Gcampb7/ECE445/arch.scad

difference(){
cylinder(0.5,3.1, 3.1, $fn = 100);
translate([-3.15,0, -0.1]){cube(6.3, 6.3, .7);}
}
