Gcampb7/ECE445/Base_Addition.scad

difference(){
    cube([15, 15, 0.5], center = true);
    cube([14.5, 14.5, 1], center =true);
}
