Gcampb7/ECE445/slip_ring_sup.scad

difference() {
    color("green"){cylinder(16.7, 13.5, 13.5, $fn= 100 );}
    translate([0,0,-0.5]){cylinder(21, 11.5, 11.5, $fn= 100 );}
    //translate([0, 20, 11]){cube([40,40,24], center = true);}
}
