Gcampb7/ECE445/(list of files, cad)

Other CAD files:
Mount12121.scad
